Ganghyeok/STM32F103RCT6-DevBoard/Schematic_PCB/STM32F103RCT6_Dev_Board_Ver1.0A.pdf

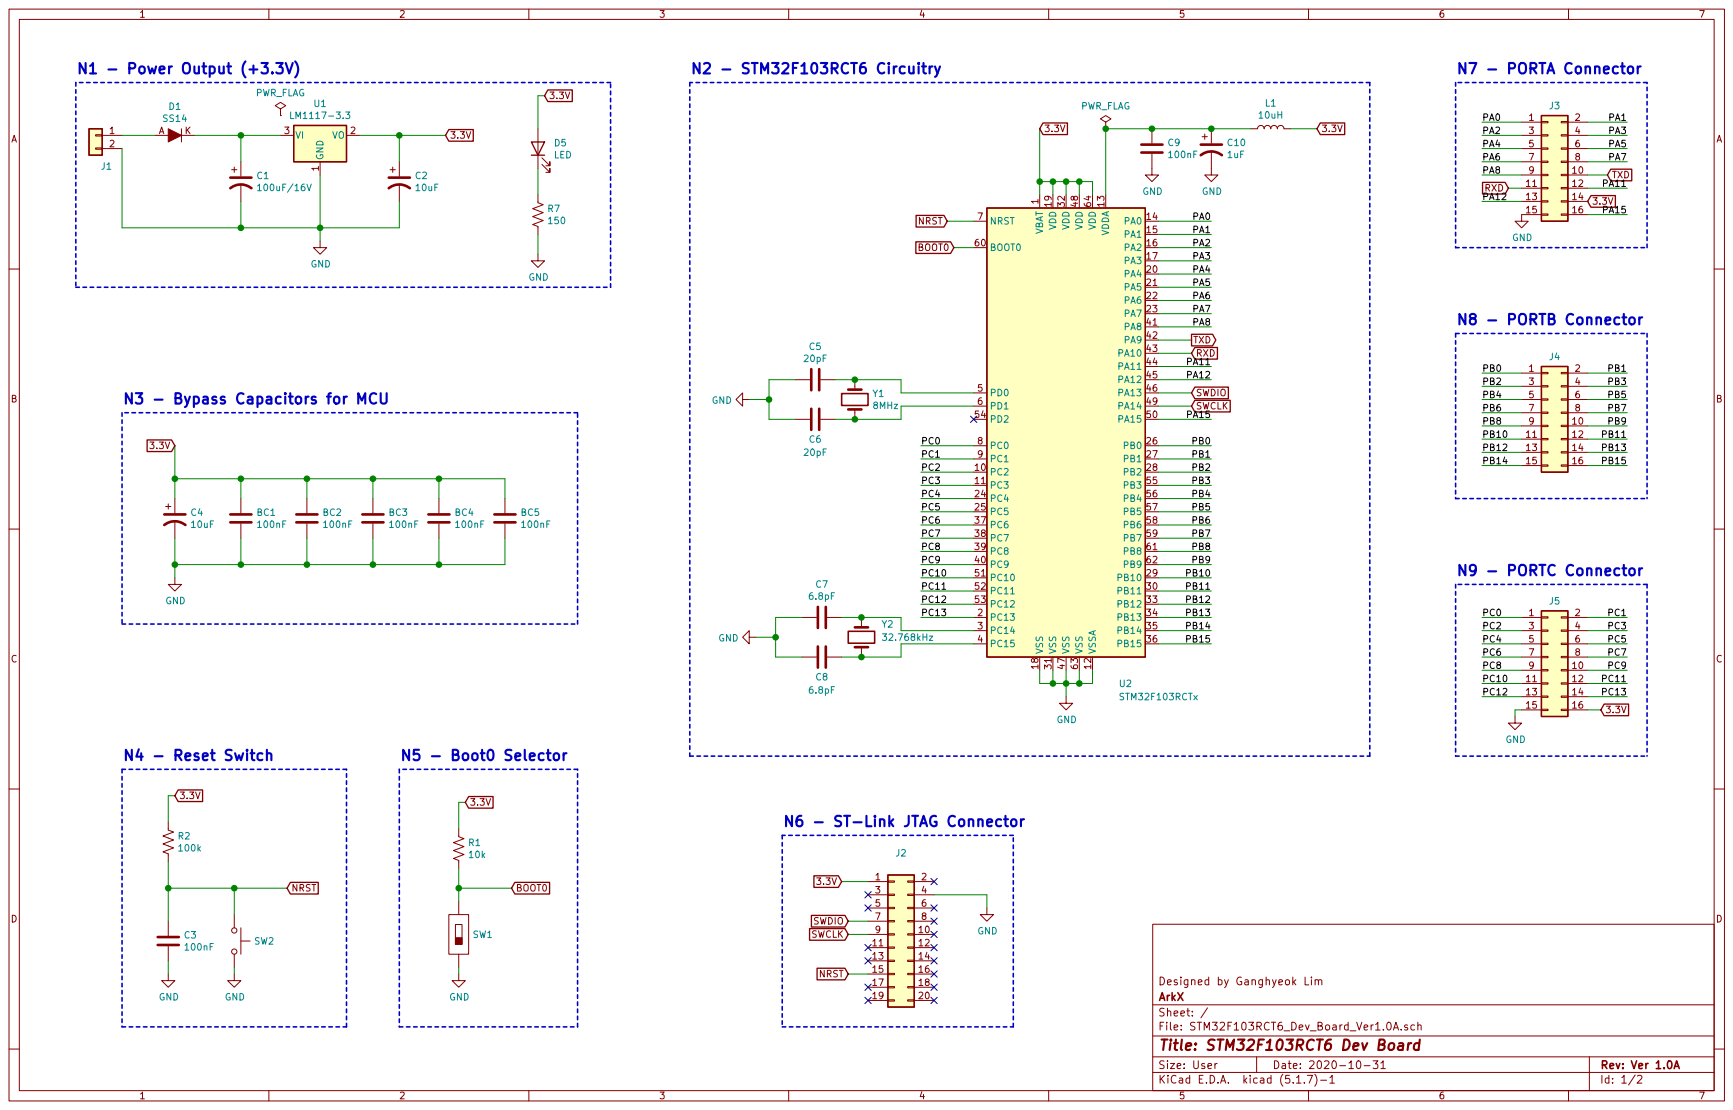
[picture p1: page 1]

1 VDD 19 VDD 32 VDD 48 VDD 64 VDDA 13 VSS 18 VSS 31 VSS 47 VSS 63 VSSA 12 U2STM32F103RCTx GND

N3 - Bypass Capacitors for MCU
SW2 GND

N6 - ST-Link JTAG Connector

File: STM32F103RCT6_Dev_Board_Ver1.0A.sch Sheet: / ArkX Designed by Ganghyeok Lim

Id: 1/2 Title: STM32F103RCT6 Dev Board

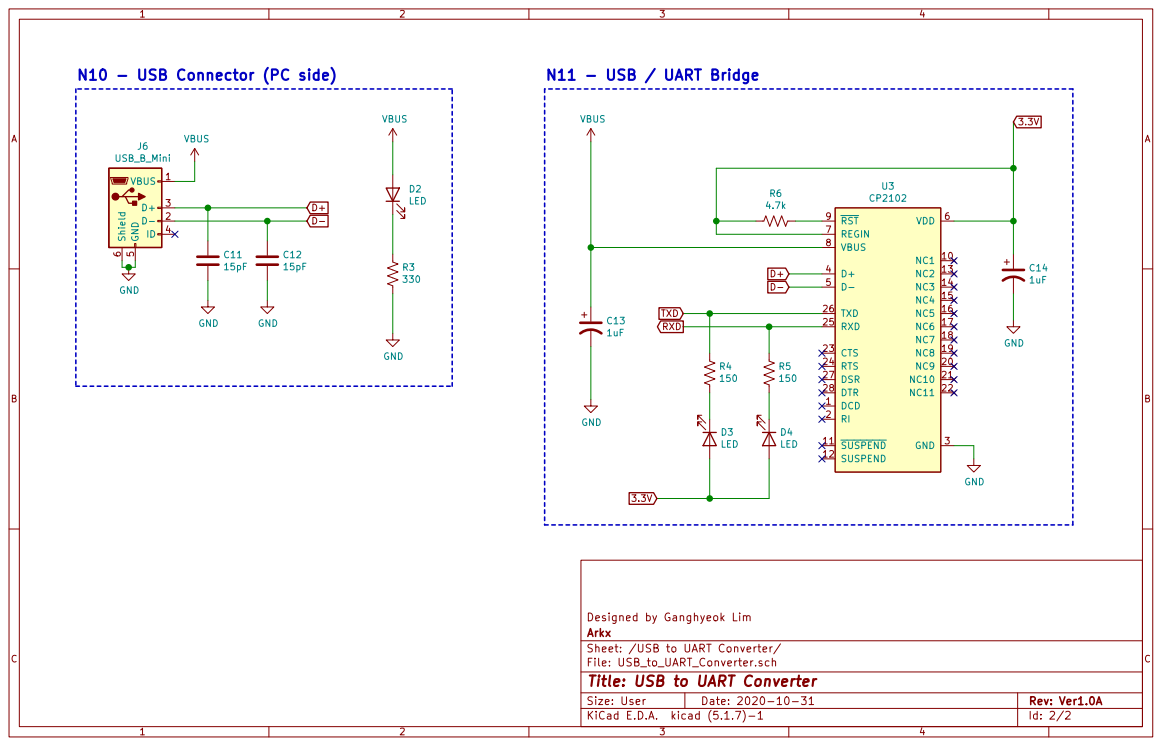
[picture p2: page 2]

File: USB_to_UART_Converter.sch Sheet: /USB to UART Converter/ Arkx Designed by Ganghyeok Lim

Id: 2/2 Title: USB to UART Converter
