Ganghyeok/STM32F103RCT6-DevBoard/Schematic_PCB/STM32F103RCT6_Dev_Board_Ver1.0A.kicad_pcb

## KiCad design Schematic_PCB/STM32F103RCT6_Dev_Board_Ver1.0A.kicad_pcb (2020-12-01)

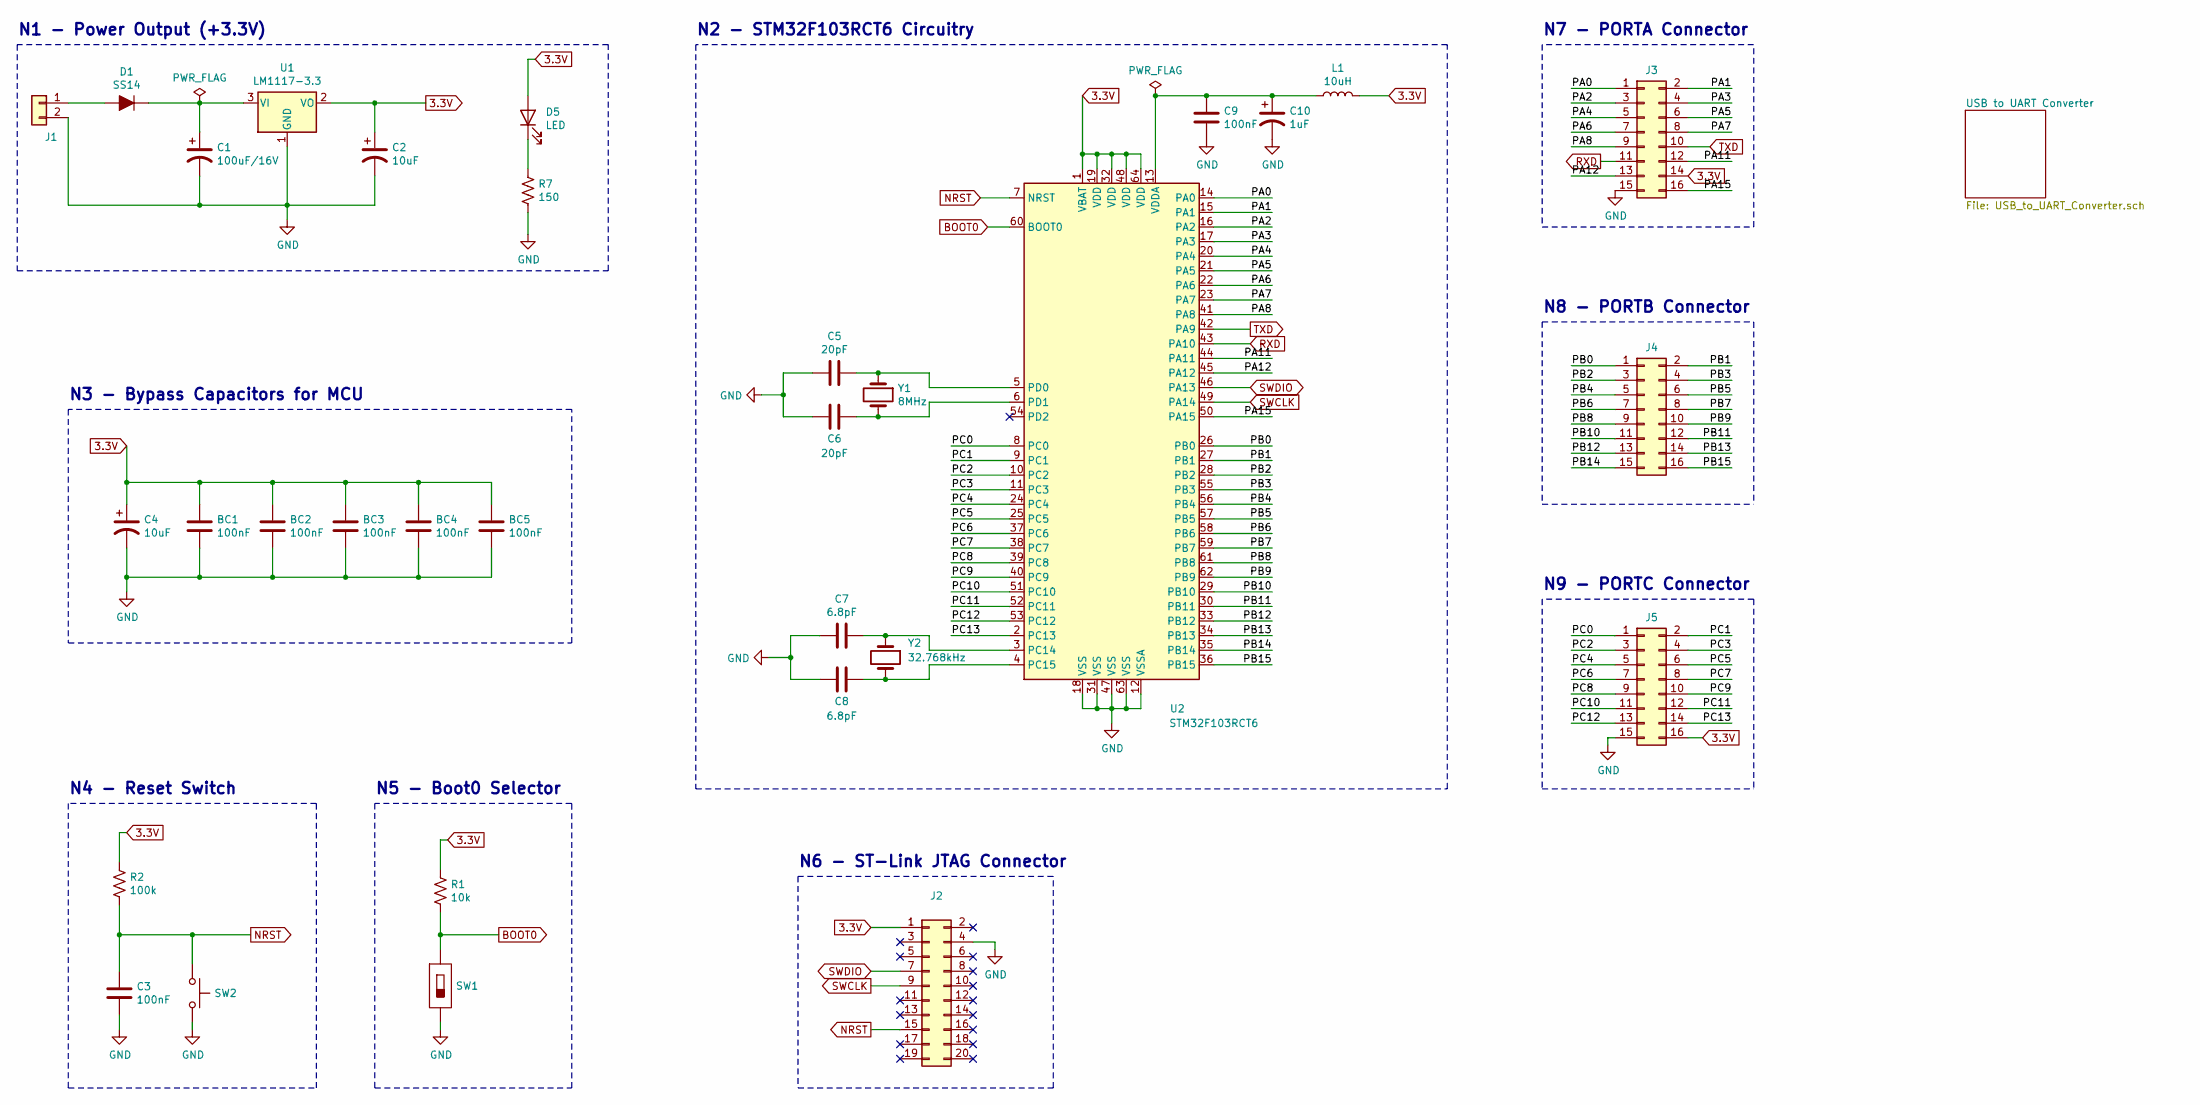
[picture p3: schematic STM32F103RCT6_Dev_Board_Ver1.0A.sch, STM32F103RCT6 Dev Board]

Parts:
BC1, BC2, BC3, BC4, BC5: 100nF; C_1206_3216Metric_Pad1.33x1.80mm_HandSolder
C1: 100uF/16V; C_Elec_6.3x5.4
C2, C4: 10uF; CP_EIA-3216-18_Kemet-A_Pad1.58x1.35mm_HandSolder
C3, C9: 100nF; C_1206_3216Metric_Pad1.33x1.80mm_HandSolder
C5, C6: 20pF; C_1206_3216Metric_Pad1.33x1.80mm_HandSolder
C7, C8: 6.8pF; C_1206_3216Metric_Pad1.33x1.80mm_HandSolder
C10: 1uF; CP_EIA-3216-18_Kemet-A_Pad1.58x1.35mm_HandSolder
D1: SS14; DO-214AC; MPN SS14; Digi-Key_PN SS14CT-ND
D5: LED; LED_1206_3216Metric_Pad1.42x1.75mm_HandSolder
J1: Conn_01x02; CON_2P_GH
J2: Conn_02x10_Odd_Even; HIF3F-20PA-2.54DSA_GH
J3, J4, J5: Conn_02x08_Odd_Even; PinSocket_2x08_P2.54mm_Vertical
L1: 10uH; L_1206_3216Metric_Pad1.22x1.90mm_HandSolder
R1: 10k; R_1206_3216Metric_Pad1.30x1.75mm_HandSolder
R2: 100k; R_1206_3216Metric_Pad1.30x1.75mm_HandSolder
R7: 150; R_1206_3216Metric_Pad1.30x1.75mm_HandSolder
SW1: SW_Slide_2P_SMD_GH; SW_Slide_6P_SMD_GH
SW2: SW_Push; SW_TACT_SMD_W3.9mm_L2.9mm_H2mm_GH
U1: LM1117-3.3; SOT-223
U2: STM32F103RCT6; LQFP-64_10x10mm_P0.5mm
Y1: 8MHz; CRYSTAL_HC49_SMD
Y2: 32.768kHz; Crystal_DS15_D1.5mm_L5.0mm_Horizontal

Connections:
3.3V: BC1.1, BC2.1, BC3.1, BC4.1, BC5.1, C2.1, C4.1, D5.2 (A), J2.1, J3.14, J5.16, L1.2, R1.1, R2.1, U1.2 (VO), U2.1 (VBAT), U2.19 (VDD), U2.32 (VDD), U2.48 (VDD), U2.64 (VDD); also elsewhere on the board
/PA0: J3.1, U2.14 (PA0)
/PA1: J3.2, U2.15 (PA1)
/PA2: J3.3, U2.16 (PA2)
/PA3: J3.4, U2.17 (PA3)
/PA4: J3.5, U2.20 (PA4)
/PA5: J3.6, U2.21 (PA5)
/PA6: J3.7, U2.22 (PA6)
/PA7: J3.8, U2.23 (PA7)
/PA8: J3.9, U2.41 (PA8)
/PA11: J3.12, U2.44 (PA11)
/PA12: J3.13, U2.45 (PA12)
/PA15: J3.16, U2.50 (PA15)
/PB0: J4.1, U2.26 (PB0)
/PB1: J4.2, U2.27 (PB1)
/PB2: J4.3, U2.28 (PB2)
/PB3: J4.4, U2.55 (PB3)
/PB4: J4.5, U2.56 (PB4)
/PB5: J4.6, U2.57 (PB5)
/PB6: J4.7, U2.58 (PB6)
/PB7: J4.8, U2.59 (PB7)
/PB8: J4.9, U2.61 (PB8)
/PB9: J4.10, U2.62 (PB9)
/PB10: J4.11, U2.29 (PB10)
/PB11: J4.12, U2.30 (PB11)
/PB12: J4.13, U2.33 (PB12)
/PB13: J4.14, U2.34 (PB13)
/PB14: J4.15, U2.35 (PB14)
/PB15: J4.16, U2.36 (PB15)
/PC0: J5.1, U2.8 (PC0)
/PC1: J5.2, U2.9 (PC1)
/PC2: J5.3, U2.10 (PC2)
/PC3: J5.4, U2.11 (PC3)
/PC4: J5.5, U2.24 (PC4)
/PC5: J5.6, U2.25 (PC5)
/PC6: J5.7, U2.37 (PC6)
/PC7: J5.8, U2.38 (PC7)
/PC8: J5.9, U2.39 (PC8)
/PC9: J5.10, U2.40 (PC9)
/PC10: J5.11, U2.51 (PC10)
/PC11: J5.12, U2.52 (PC11)
/PC12: J5.13, U2.53 (PC12)
/PC13: J5.14, U2.2 (PC13)
BOOT0: R1.2, SW1.1, U2.60 (BOOT0)
GND: BC1.2, BC2.2, BC3.2, BC4.2, BC5.2, C1.2, C2.2, C3.2, C4.2, C5.2, C6.2, C7.2, C8.2, C9.2, C10.2, J1.2, J2.4, J3.15, J5.15, R7.2, SW1.2, SW2.2, U1.1 (GND), U2.12 (VSSA), U2.18 (VSS), U2.31 (VSS), U2.47 (VSS), U2.63 (VSS); also elsewhere on the board
NRST: C3.1, J2.15, R2.2, SW2.1, U2.7 (NRST)
unnamed: C1.1, D1.K, U1.3 (VI)
unnamed: C5.1, U2.5 (PD0), Y1.1
unnamed: C6.1, U2.6 (PD1), Y1.2
unnamed: C7.1, U2.3 (PC14), Y2.1
unnamed: C8.1, U2.4 (PC15), Y2.2
unnamed: C9.1, C10.1, L1.1, U2.13 (VDDA)
unnamed: D1.A, J1.1
unnamed: D5.1 (K), R7.1
RXD: J3.11, U2.43 (PA10); also elsewhere on the board
SWCLK: J2.9, U2.49 (PA14)
SWDIO: J2.7, U2.46 (PA13)
TXD: J3.10, U2.42 (PA9); also elsewhere on the board

Notes on the sheet:
N1 - Power Output (+3.3V)
N2 - STM32F103RCT6 Circuitry
N4 - Reset Switch
N5 - Boot0 Selector
N3 - Bypass Capacitors for MCU
N6 - ST-Link JTAG Connector
N7 - PORTA Connector
N8 - PORTB Connector
N9 - PORTC Connector

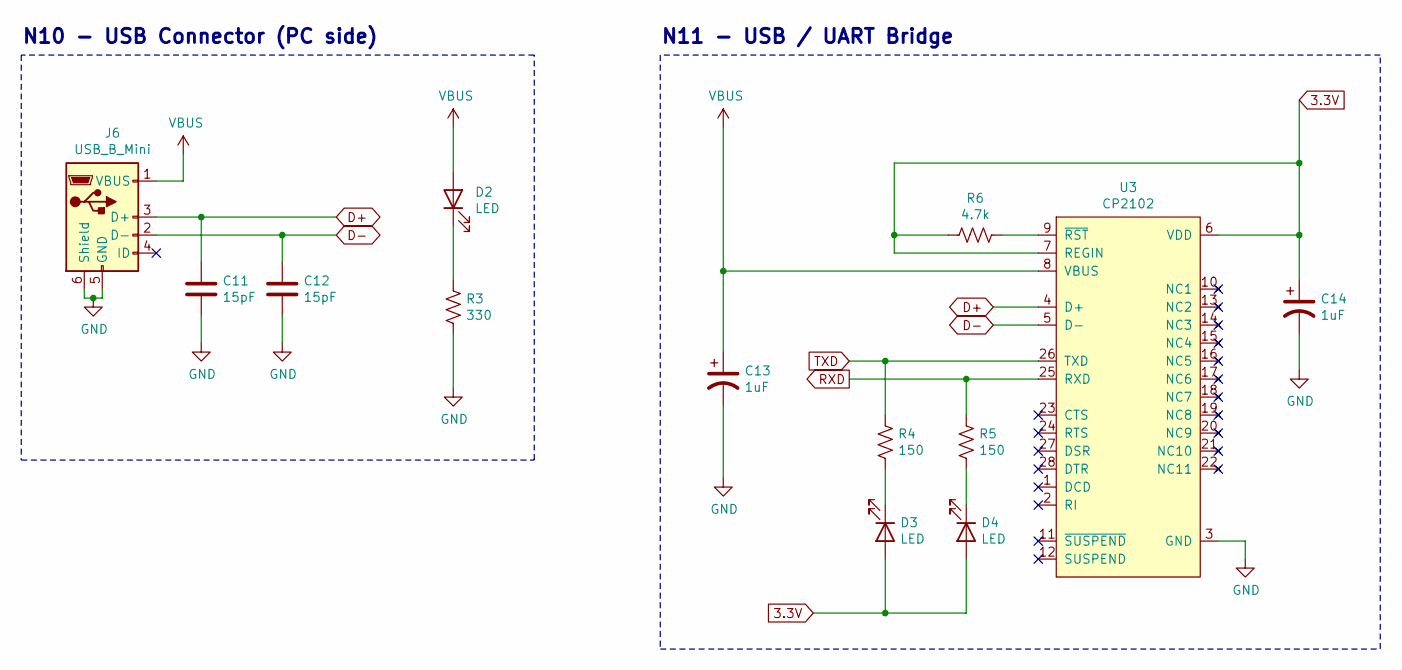
[picture p4: schematic USB_to_UART_Converter.sch, USB to UART Converter]

Parts:
C11, C12: 15pF; C_1206_3216Metric_Pad1.33x1.80mm_HandSolder
C13, C14: 1uF; CP_EIA-3216-18_Kemet-A_Pad1.58x1.35mm_HandSolder
D2, D3, D4: LED; LED_1206_3216Metric_Pad1.42x1.75mm_HandSolder
J6: USB_B_Mini; USB_Mini-B_Lumberg_2486_01_Horizontal
R3: 330; R_1206_3216Metric_Pad1.30x1.75mm_HandSolder
R4, R5: 150; R_1206_3216Metric_Pad1.30x1.75mm_HandSolder
R6: 4.7k; R_1206_3216Metric_Pad1.30x1.75mm_HandSolder
U3: CP2102; VFQFN-28-1EP_5x5mm_HandSolder

Connections:
3.3V: C14.1, D3.2 (A), D4.2 (A), R6.1, U3.6 (VDD), U3.7 (REGIN); also elsewhere on the board
D+: C11.1, J6.3 (D+), U3.4 (D+)
D-: C12.1, J6.2 (D-), U3.5 (D-)
GND: C11.2, C12.2, C13.2, C14.2, J6.5 (GND), J6.6 (Shield), R3.1, U3.3 (GND); also elsewhere on the board
unnamed: D2.1 (K), R3.2
unnamed: D3.1 (K), R4.1
unnamed: D4.1 (K), R5.1
unnamed: R6.2, U3.9 (~RST)
RXD: R5.2, U3.25 (RXD); also elsewhere on the board
TXD: R4.2, U3.26 (TXD); also elsewhere on the board
VBUS: C13.1, D2.2 (A), J6.1 (VBUS), U3.8 (VBUS)

Notes on the sheet:
N10 - USB Connector (PC side)
N11 - USB / UART Bridge

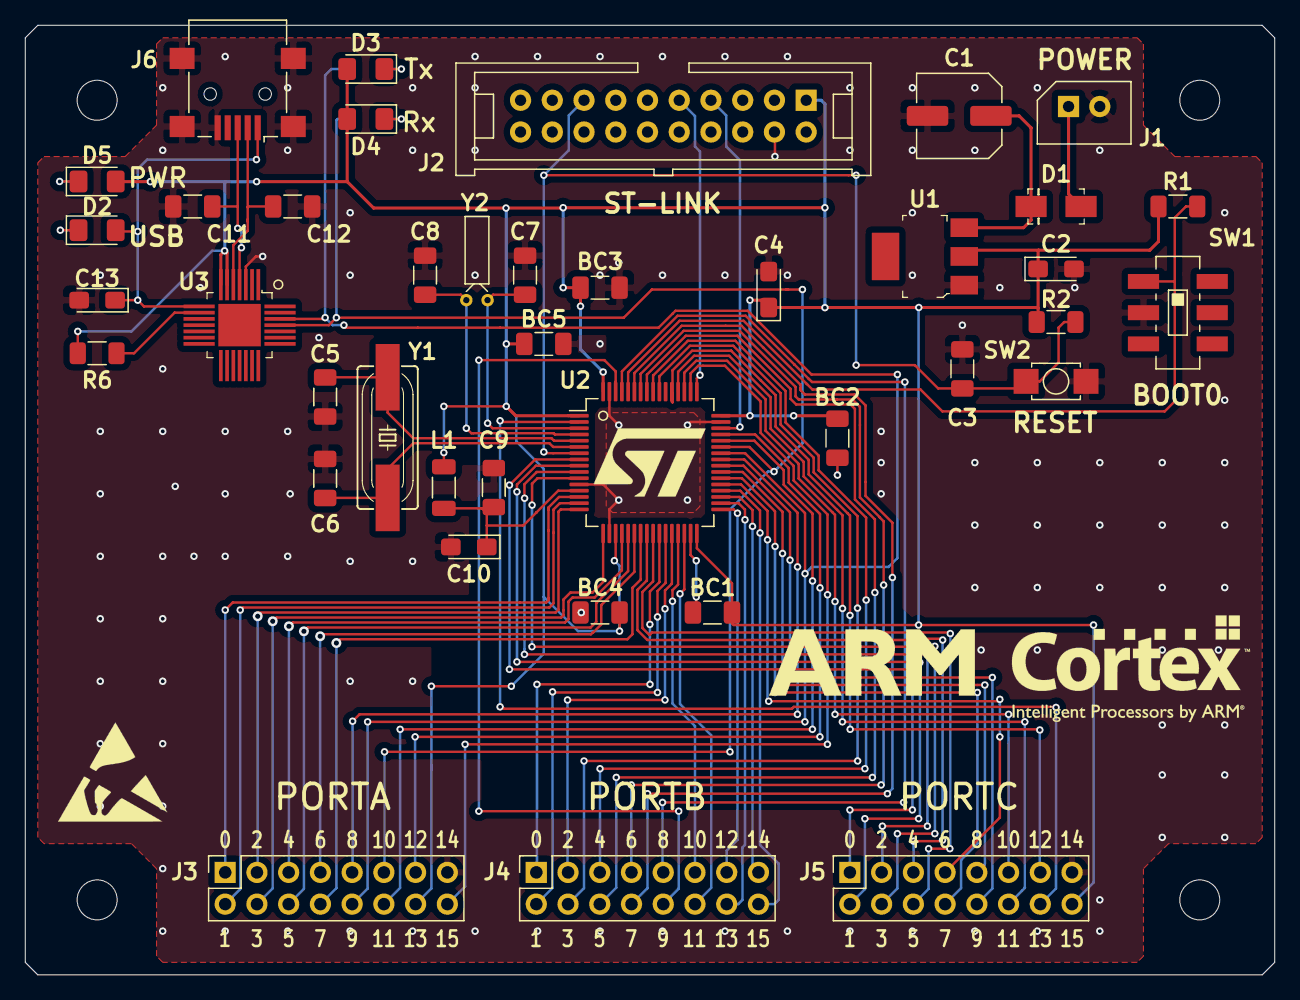
[picture p5: board STM32F103RCT6_Dev_Board_Ver1.0A.kicad_pcb from above]

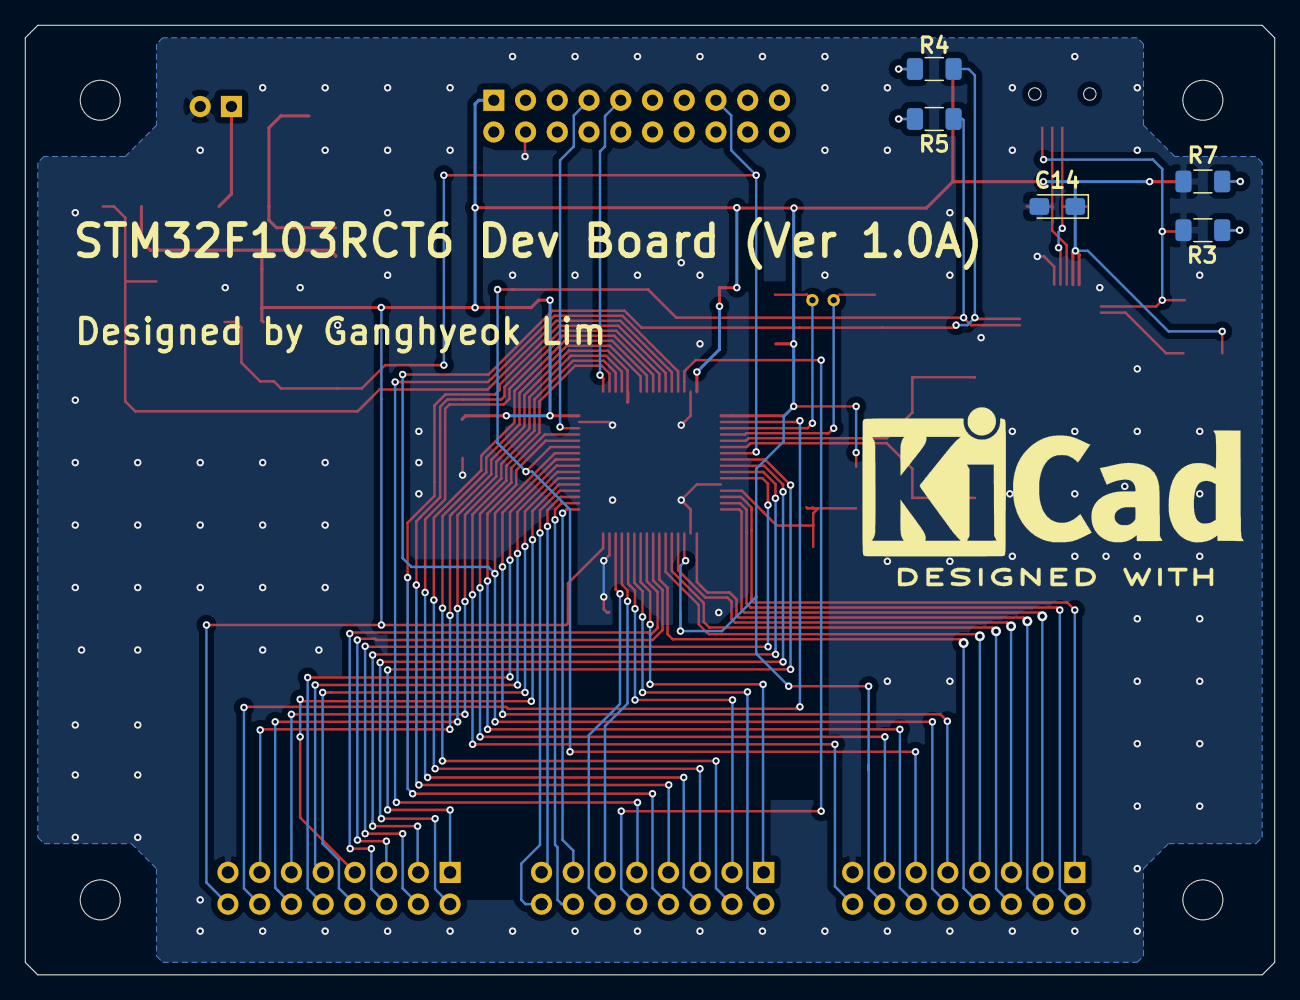
[picture p6: board STM32F103RCT6_Dev_Board_Ver1.0A.kicad_pcb from below]

Board: 2 copper layers, 100.0 x 76.0 mm, 45 parts (5 on the bottom side), 65 nets.
