Ganghyeok/STM32F103RCT6-DevBoard/Firmware/STM32F103RCT6-DevBoard/Src/main.c

/**
 ******************************************************************************
 * @file           : main.c
 * @author         : Auto-generated by STM32CubeIDE
 * @brief          : Main program body
 ******************************************************************************
 * @attention
 *
 * <h2><center>&copy; Copyright (c) 2019 STMicroelectronics.
 * All rights reserved.</center></h2>
 *
 * This software component is licensed by ST under BSD 3-Clause license,
 * the "License"; You may not use this file except in compliance with the
 * License. You may obtain a copy of the License at:
 *                        opensource.org/licenses/BSD-3-Clause
 *
 ******************************************************************************
 */

/*
 *  TIM1_CH1 : PA8
 *  TIM1_CH2 : PA9
 *  TIM1_CH3 : PA10
 *  TIM1_CH4 : PA11
 *  -> Output Compare channel -> AF Push-Pull
 */


#include "stm32f103xx.h"


void GPIO_LEDInit(GPIO_HandleTypeDef *pGPIOHandle);
void USART1_Init(UART_HandleTypeDef *pUSARTHandle);
void TIM1_Init(TIM_HandleTypeDef *pTIMHandle);

UART_HandleTypeDef USART1Handle;
TIM_HandleTypeDef TIMHandle;

//char str1[15] = "Hello World!\n\r";
//char str2[17] = "VAPALUX_Clever\n\r";


int main(void)
{
	//memset(&USART1Handle, 0, sizeof(USART1Handle));

	SystemClock_Config(SYSCLK_FREQ_72MHZ);		// Other SYSCLK options are available

	// 1. Low level initialization of UART with GPIO clock enable
	//USART_LowInit(USART1);

	// 2. UART initialization with UART Clock enable
	//USART1_Init(&USART1Handle);

	//NVIC_IRQConfig(IRQ_NO_USART1, NVIC_PRIOR_8, ENABLE);

	Delay_ms(10);

	/* ---------------------------------------------------------------------------- */

	memset(&TIMHandle, 0, sizeof(TIMHandle));

	TIM1_Init(&TIMHandle);

	TIM_PWM_Start(&TIMHandle, TIM_CHANNEL_1);
	TIM_PWM_Start(&TIMHandle, TIM_CHANNEL_2);
	TIM_PWM_Start(&TIMHandle, TIM_CHANNEL_3);
	TIM_PWM_Start(&TIMHandle, TIM_CHANNEL_4);

	while(1);
}


void GPIO_LEDInit(GPIO_HandleTypeDef *pGPIOHandle)
{
	pGPIOHandle->Instance = GPIOA;
	pGPIOHandle->Init.Mode = GPIO_MODE_OUTPUT_PP;
	pGPIOHandle->Init.Pin = GPIO_PIN_0;
	pGPIOHandle->Init.Pull = GPIO_NOPULL;
	pGPIOHandle->Init.Speed = GPIO_SPEED_FREQ_LOW;

	GPIO_Init(GPIOA, &pGPIOHandle->Init);
}


void USART1_Init(UART_HandleTypeDef *pUSARTHandle)
{
	pUSARTHandle->Instance = USART1;
	pUSARTHandle->Init.Mode = UART_MODE_TX;
	pUSARTHandle->Init.BaudRate = USART_STD_BAUD_115200;
	pUSARTHandle->Init.OverSampling = UART_OVERSAMPLING_16;
	pUSARTHandle->Init.HwFlowCtl = UART_HWCONTROL_NONE;
	pUSARTHandle->Init.Parity = UART_PARITY_NONE;
	pUSARTHandle->Init.StopBits = UART_STOPBITS_1;
	pUSARTHandle->Init.WordLength = UART_WORDLENGTH_8B;
	pUSARTHandle->State = USART_STATE_READY;

	USART_Init(pUSARTHandle);
}


void TIM1_Init(TIM_HandleTypeDef *pTIMHandle)
{
	// TIM Init Structure config
	pTIMHandle->Instance = TIM1;
	pTIMHandle->Init.Prescaler = (720-1);  //   72MHz / 720 = 100kHz
	pTIMHandle->Init.Period = (10-1);  //   100kHz / 10 = 10kHz
	// TIM Base Initialization
	TIM_BaseInit(pTIMHandle);

	// TIM Low level Initialization
	TIM_LowInit(pTIMHandle->Instance);

	TIM_OC_InitTypeDef TIM1_PWMConfig;
	memset(&TIM1_PWMConfig, 0, sizeof(TIM1_PWMConfig));

	// TIM_PWM_Config
	TIM1_PWMConfig.OCMode = TIM_OCMODE_PWM1;
	TIM1_PWMConfig.OCPolarity = TIM_OCPOLARITY_HIGH;
	TIM1_PWMConfig.Pulse = 2;	// 20% duty
	TIM_PWM_ConfigChannel(pTIMHandle, &TIM1_PWMConfig, TIM_CHANNEL_1);

	TIM1_PWMConfig.OCMode = TIM_OCMODE_PWM1;
	TIM1_PWMConfig.OCPolarity = TIM_OCPOLARITY_HIGH;
	TIM1_PWMConfig.Pulse = 4;	// 40% duty
	TIM_PWM_ConfigChannel(pTIMHandle, &TIM1_PWMConfig, TIM_CHANNEL_2);

	TIM1_PWMConfig.OCMode = TIM_OCMODE_PWM1;
	TIM1_PWMConfig.OCPolarity = TIM_OCPOLARITY_HIGH;
	TIM1_PWMConfig.Pulse = 6;	// 60% duty
	TIM_PWM_ConfigChannel(pTIMHandle, &TIM1_PWMConfig, TIM_CHANNEL_3);

	TIM1_PWMConfig.OCMode = TIM_OCMODE_PWM1;
	TIM1_PWMConfig.OCPolarity = TIM_OCPOLARITY_HIGH;
	TIM1_PWMConfig.Pulse = 8;	// 80% duty
	TIM_PWM_ConfigChannel(pTIMHandle, &TIM1_PWMConfig, TIM_CHANNEL_4);
}
