Ganghyeok/STM32F103RCT6-DevBoard/(commit log)

2020-12-01 Add PCB files that have already been produced and tested
    [STM32F103RCT6_Dev_Board_Ver1.0A.kicad_pcb, STM32F103RCT6_Dev_Board_Ver1.0A.sch, USB_to_UART_Converter.sch]
2020-12-01 Create STM32 project(FW)
2020-12-02 Create MCU specific Header file(stm32f103xx.h)
2020-12-03 TEST System Clock configuration of PLL out
    - Add Test code of System Clock of MCU to check whether it is PLL output or not
    - Update stm32f103xx.h
    : Replace Kiran style contents with HAL style contents
    - Update stm32f103xx_rcc_driver.c, .h
    : Replace Kiran style contents with HAL style contents
    [main.c]
2020-12-05 [Add & Test] GPIO driver
    - Add GPIO_Init
    GPIO_ReadPin
    GPIO_WritePin
    GPIO_TogglePin
    NVIC_IRQConfig
    - Test (PASS) GPIO port initialization
    (PASS) GPIO pin read operation
    (PASS) GPIO pin write operation
    (PASS) GPIO pint toggle operation
    (PASS) EXTI handler execution (triggered by R/F/R&F edge conditions.)
2020-12-06 [Update] delay function with high accuracy
    - Add Memory mapping of Core Hardware, including SysTick timer's (stm32f103xx.h)
    Peripheral Declarations of Core Hardware, including SysTick timer's (core.h)
    SysTick structure type (core.h)
    - Relocation NVIC structure type / NVIC_IRQConfig function (to core.h, core.c)
    - Update delay functions (Delay_us, Delay_ms)
    - Test Toggle LED with updated delay functions
    Delay value Error value (%)
    ---------------------------------------
    10us -> 1.4us (14%)
    100us -> 1.25us (1.25%)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
    [core.c, core.h, it.c, main.c]
2020-12-11 [Add & Test] UART Transmit by Polling mode
    - Add USART driver file (stm32f103xx_usart_driver.h, .c)
    RCC_GetPLLOutputClock function
    RCC_GetPCLKxValue function
    - Test (PASS) UART Transmit data to PC (Polling mode)
2020-12-11 [Add & Test] UART Transmit by Interrupt mode
    - Add USART_Transmit_IT
    - Test (PASS) UART Transmit by Interrupt mode
2020-12-15 [Add & Test] TIM Base interrupt generation
    - Add TIM driver file (stm32f103xx_tim_driver.h, .c)
    - Test (PASS) TIM Base 1Hz interrupt generation
2020-12-17 [Add & Test] TIM PWM generation for ch1~4
    - Add TIM PWM related functions
    - Test (PASS) TIM PWM generation for ch1~4 with arbitrary duty
